enwi/RoomSensor/pcb/RoomSensor.kicad_pcb

## KiCad design pcb/RoomSensor.kicad_pcb (2023-08-02)

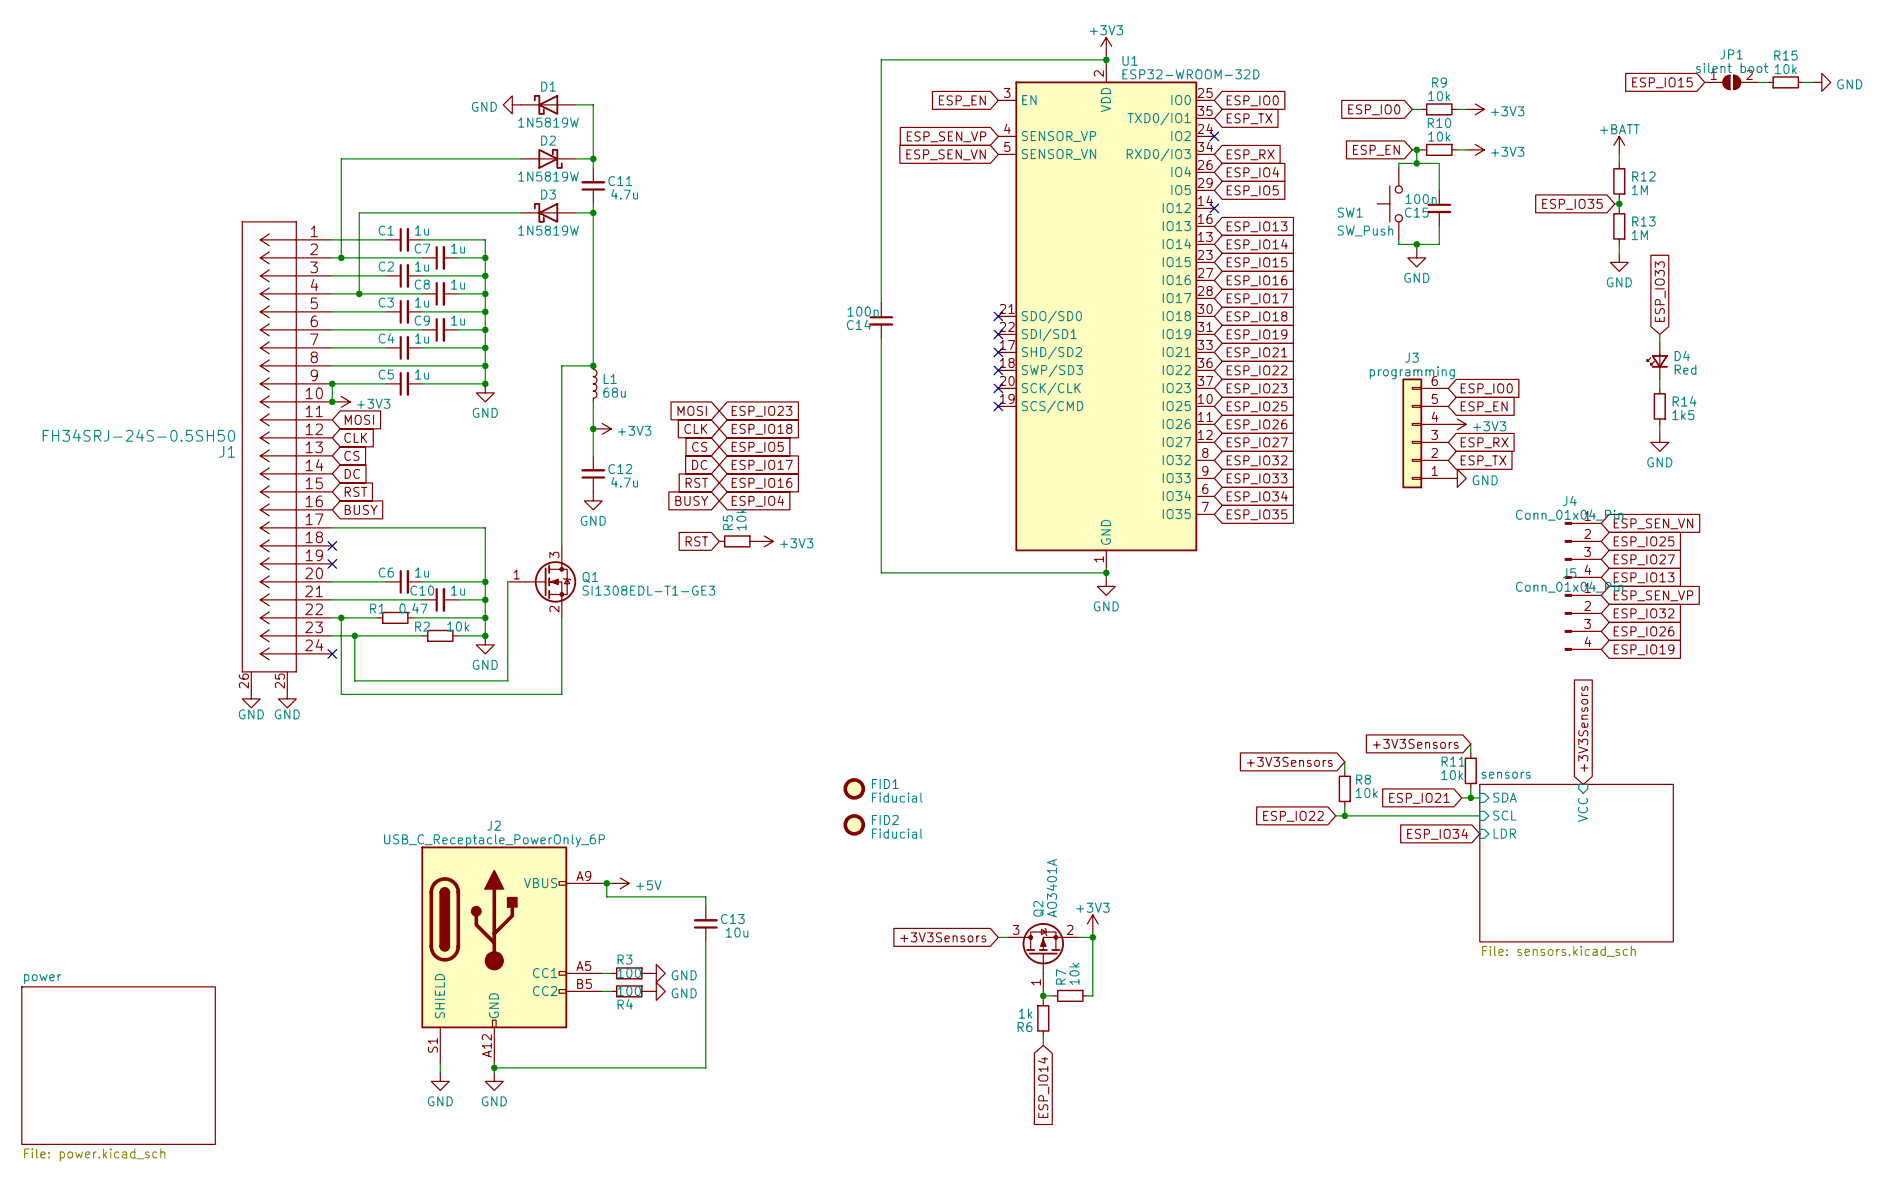
[picture p1: schematic RoomSensor.kicad_sch]

Parts:
C1, C2, C3, C4, C5, C6, C7, C8, C9, C10: 1u; C_0603_1608Metric
C11, C12: 4.7u; C_0603_1608Metric
C13: 10u; C_0603_1608Metric
C14, C15: 100n; C_0603_1608Metric
D1, D2, D3: 1N5819W; D_SOD-323
D4: Red; LED_0603_1608Metric
FID1, FID2: Fiducial; Fiducial_0.5mm_Mask1.5mm
J1: FH34SRJ-24S-0.5SH50
J2: USB_C_Receptacle_PowerOnly_6P; TYPE-C 6P LCH10.0
J3: programming; PinSocket_1x06_P2.54mm_Vertical
J4, J5: Conn_01x04_Pin; PinHeader_1x04_P2.54mm_Vertical
JP1: silent boot; SolderJumper-2_P1.3mm_Open_TrianglePad1.0x1.5mm
L1: 68u; L_0805_2012Metric_Pad1.15x1.40mm_HandSolder
Q1: SI1308EDL-T1-GE3; SOT-323_SC-70
Q2: AO3401A; SOT-23
R1: 0.47; R_0603_1608Metric
R2, R5, R7, R8, R9, R10, R11, R15: 10k; R_0603_1608Metric
R3, R4: 100; R_0603_1608Metric
R6: 1k; R_0603_1608Metric
R12, R13: 1M; R_0603_1608Metric
R14: 1k5; R_0603_1608Metric
SW1: SW_Push; TSB001A3826A
U1: ESP32-WROOM-32D

Connections:
+3V3: C5.1, C12.2, C14.1, J1.9, J1.10, J3.4, L1.2, Q2.2 (S), R5.1, R7.1, R9.2, R10.1, U1.2 (VDD); also elsewhere on the board
+3V3Sensors: Q2.3 (D), R8.2, R11.2; also elsewhere on the board
+5V: C13.2, J2.A9 (VBUS), J2.B9 (VBUS); also elsewhere on the board
+BATT: R12.2; also elsewhere on the board
BUSY: J1.16, U1.26 (IO4)
CLK: J1.12, U1.30 (IO18)
CS: J1.13, U1.29 (IO5)
DC: J1.14, U1.28 (IO17)
ESP_EN: C15.1, J3.5, R10.2, SW1.2, U1.3 (EN)
ESP_IO0: J3.6, R9.1, U1.25 (IO0)
ESP_IO13: J4.4, U1.16 (IO13)
ESP_IO14: R6.2, U1.13 (IO14)
ESP_IO15: JP1.1 (A), U1.23 (IO15)
ESP_IO16: J1.15, R5.2, U1.27 (IO16)
ESP_IO19: J5.4, U1.31 (IO19)
ESP_IO21: R11.1, U1.33 (IO21); also elsewhere on the board
ESP_IO22: R8.1, U1.36 (IO22); also elsewhere on the board
ESP_IO23: J1.11, U1.37 (IO23)
ESP_IO25: J4.2, U1.10 (IO25)
ESP_IO26: J5.3, U1.11 (IO26)
ESP_IO27: J4.3, U1.12 (IO27)
ESP_IO32: J5.2, U1.8 (IO32)
ESP_IO33: D4.2 (A), U1.9 (IO33)
ESP_IO34: U1.6 (IO34); also elsewhere on the board
ESP_IO35: R12.1, R13.2, U1.7 (IO35)
ESP_RX: J3.3, U1.34 (RXD0/IO3)
ESP_SEN_VN: J4.1, U1.5 (SENSOR_VN)
ESP_SEN_VP: J5.1, U1.4 (SENSOR_VP)
ESP_TX: J3.2, U1.35 (TXD0/IO1)
GND: C1.2, C2.2, C3.2, C4.2, C5.2, C6.2, C7.2, C8.2, C9.2, C10.2, C12.1, C13.1, C14.2, C15.2, D1.1 (K), J1.8, J1.17, J1.25, J1.26, J2.A12 (GND), J2.B12 (GND), J2.S1 (SHIELD), J3.1, R1.2, R2.2, R3.1, R4.1, R13.1, R14.1, R15.2, SW1.1, U1.1 (GND), U1.15 (GND), U1.38 (GND), U1.39 (GND); also elsewhere on the board
unnamed: C1.1, J1.1
unnamed: C2.1, J1.3
unnamed: C3.1, J1.5
unnamed: C4.1, J1.7
unnamed: C6.1, J1.20
unnamed: C9.1, J1.6
unnamed: C10.1, J1.21
unnamed: C11.2, D1.2 (A), D2.1 (K)
unnamed: C7.1, D2.2 (A), J1.2
unnamed: C11.1, D3.2 (A), L1.1, Q1.3 (D)
unnamed: C8.1, D3.1 (K), J1.4
unnamed: D4.1 (K), R14.2
unnamed: J2.A5 (CC1), R3.2
unnamed: J2.B5 (CC2), R4.2
unnamed: JP1.2 (B), R15.1
unnamed: J1.23, Q1.1 (G), R2.1
unnamed: J1.22, Q1.2 (S), R1.1
unnamed: Q2.1 (G), R6.1, R7.2

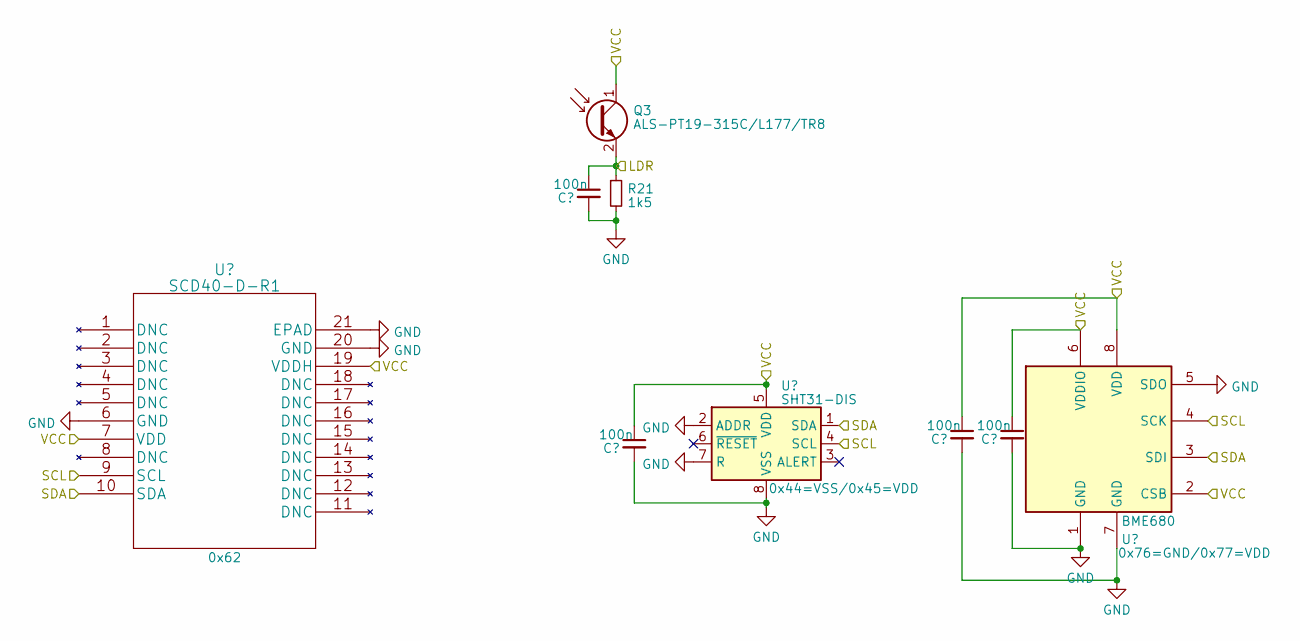
[picture p2: schematic sensors.kicad_sch]

Parts:
C21, C22, C23, C24: 100n; C_0603_1608Metric
Q3: ALS-PT19-315C/L177/TR8; LED_0603_1608Metric
R21: 1k5; R_0603_1608Metric
U6: SCD40-D-R1
U7: SHT31-DIS; Sensirion_DFN-8-1EP_2.5x2.5mm_P0.5mm_EP1.1x1.7mm
U8: BME680; Bosch_LGA-8_3x3mm_P0.8mm_ClockwisePinNumbering

Connections:
+3V3Sensors: C22.1, C23.1, C24.1, Q3.1 (C), U6.7 (VDD), U6.19 (VDDH), U7.5 (VDD), U8.2 (CSB), U8.6 (VDDIO), U8.8 (VDD); also elsewhere on the board
ESP_IO21: U6.10 (SDA), U7.1 (SDA), U8.3 (SDI); also elsewhere on the board
ESP_IO22: U6.9 (SCL), U7.4 (SCL), U8.4 (SCK); also elsewhere on the board
ESP_IO34: C21.1, Q3.2 (E), R21.1; also elsewhere on the board
GND: C21.2, C22.2, C23.2, C24.2, R21.2, U6.6 (GND), U6.20 (GND), U6.21 (EPAD), U7.2 (ADDR), U7.7 (R), U7.8 (VSS), U7.9 (VSS), U8.1 (GND), U8.5 (SDO), U8.7 (GND); also elsewhere on the board

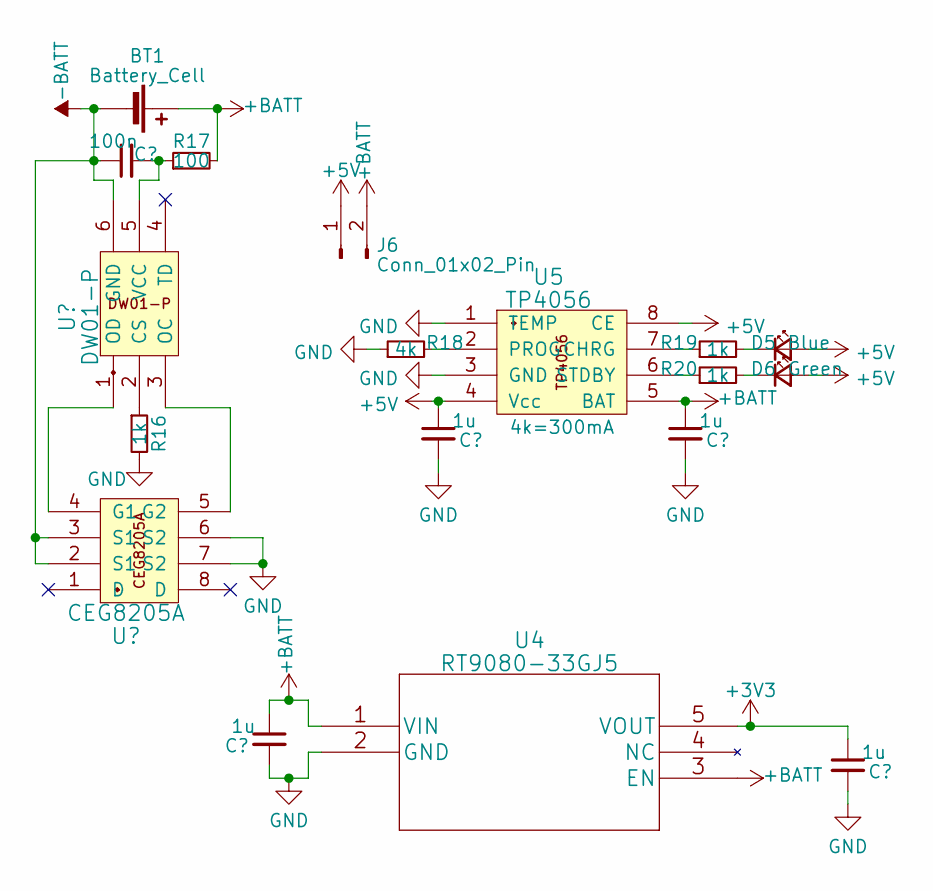
[picture p3: schematic power.kicad_sch]

Parts:
BT1: Battery_Cell; PinHeader_1x02_P2.54mm_Vertical
C16: 100n; C_0603_1608Metric
C17, C18, C19, C20: 1u; C_0603_1608Metric
D5: Blue; LED_0603_1608Metric
D6: Green; LED_0603_1608Metric
J6: Conn_01x02_Pin; PinHeader_1x02_P2.54mm_Vertical
R16, R19, R20: 1k; R_0603_1608Metric
R17: 100; R_0603_1608Metric
R18: 4k; R_0603_1608Metric
U2: DW01-P; SOT-23-6
U3: CEG8205A; TSSOP-8_4.4x3mm_P0.65mm
U4: RT9080-33GJ5
U5: TP4056; SOIC-8-1EP_3.9x4.9mm_P1.27mm_EP2.29x3mm_ThermalVias

Connections:
+3V3: C20.1, U4.5 (VOUT); also elsewhere on the board
+5V: C18.1, D5.2 (A), D6.2 (A), J6.1, U5.4 (Vcc), U5.8 (CE); also elsewhere on the board
+BATT: BT1.1 (+), C17.1, C19.1, J6.2, R17.2, U4.1 (VIN), U4.3 (EN), U5.5 (BAT); also elsewhere on the board
-BATT: BT1.2 (-), C16.1, U2.6 (GND), U3.2 (S1), U3.3 (S1)
GND: C17.2, C18.2, C19.2, C20.2, R16.2, R18.1, U3.6 (S2), U3.7 (S2), U4.2 (GND), U5.1 (TEMP), U5.3 (GND), U5.9 (HeatPad); also elsewhere on the board
unnamed: D5.1 (K), R19.2
unnamed: D6.1 (K), R20.2
unnamed: R16.1, U2.2 (CS)
unnamed: U2.3 (OC), U3.5 (G2)
unnamed: U2.1 (OD), U3.4 (G1)
unnamed: C16.2, R17.1, U2.5 (VCC)
unnamed: R19.1, U5.7 (CHRG)
unnamed: R18.2, U5.2 (PROG)
unnamed: R20.1, U5.6 (STDBY)

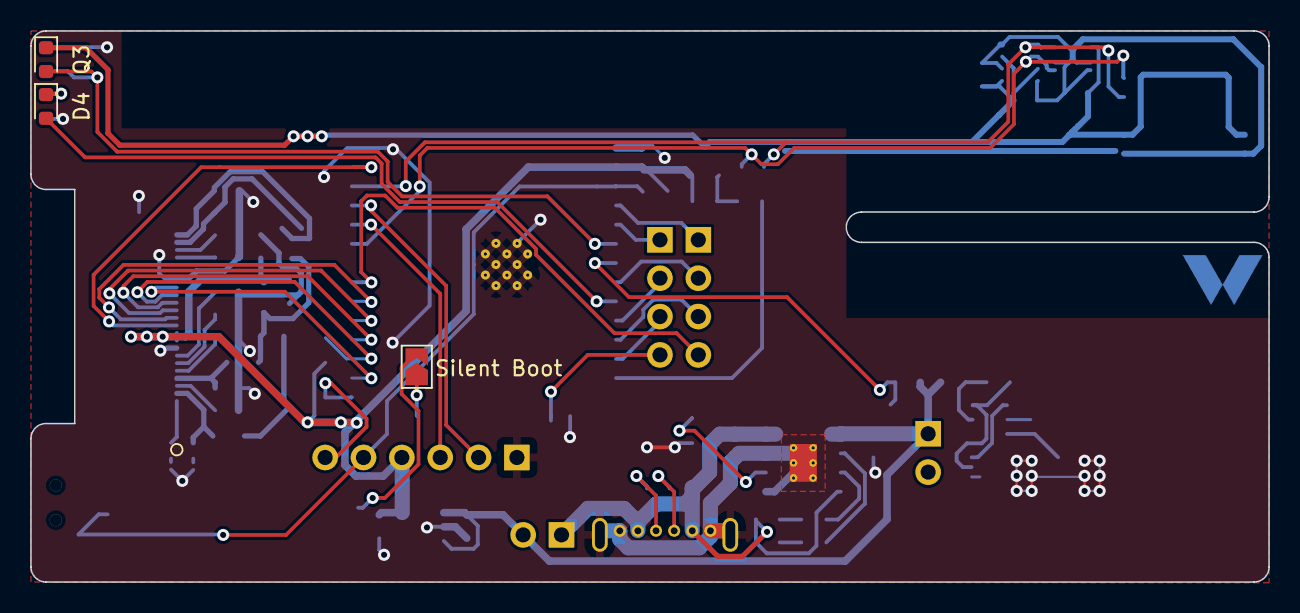
[picture p4: board RoomSensor.kicad_pcb from above]

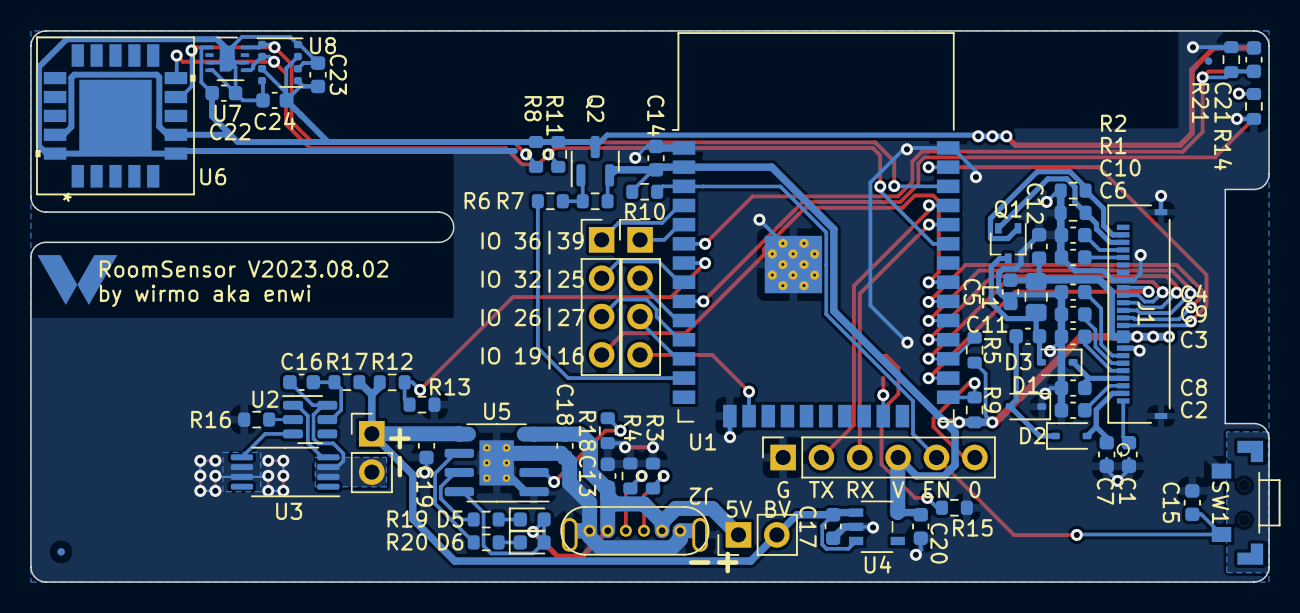
[picture p5: board RoomSensor.kicad_pcb from below]

Board: 2 copper layers, 82.0 x 36.5 mm, 74 parts (71 on the bottom side), 58 nets.
