enwi/RoomSensor/code/include/Icons.h

// 'humidity', 50x50px
unsigned char epd_bitmap_humidity[] PROGMEM = {0x00, 0x00, 0x00, 0x00, 0x00, 0x00, 0x00, 0x00, 0x00, 0x00, 0xe0, 0x00,
    0x00, 0x00, 0x00, 0x00, 0x00, 0xe0, 0x00, 0x00, 0x00, 0x00, 0x00, 0x01, 0xf0, 0x00, 0x00, 0x00, 0x00, 0x00, 0x01,
    0xf0, 0x00, 0x00, 0x00, 0x00, 0x00, 0x03, 0xf8, 0x00, 0x00, 0x00, 0x00, 0x00, 0x07, 0xfc, 0x00, 0x00, 0x00, 0x00,
    0x00, 0x07, 0x1c, 0x00, 0x00, 0x00, 0x00, 0x00, 0x0f, 0x1e, 0x00, 0x00, 0x00, 0x00, 0x00, 0x0e, 0x0e, 0x00, 0x00,
    0x00, 0x00, 0x00, 0x1c, 0x07, 0x00, 0x00, 0x00, 0x00, 0x00, 0x1c, 0x07, 0x00, 0x00, 0x00, 0x00, 0x00, 0x38, 0x03,
    0x80, 0x00, 0x00, 0x00, 0x00, 0x78, 0x03, 0xc0, 0x00, 0x00, 0x00, 0x00, 0x70, 0x01, 0xc0, 0x00, 0x00, 0x00, 0x00,
    0xf0, 0x01, 0xe0, 0x00, 0x00, 0x00, 0x00, 0xe0, 0x00, 0xe0, 0x00, 0x00, 0x00, 0x01, 0xc0, 0x00, 0x70, 0x00, 0x00,
    0x00, 0x03, 0xc0, 0x00, 0x78, 0x00, 0x00, 0x00, 0x03, 0x80, 0x00, 0x38, 0x00, 0x00, 0x00, 0x07, 0x80, 0x00, 0x3c,
    0x00, 0x00, 0x00, 0x07, 0x00, 0x00, 0x1c, 0x00, 0x00, 0x00, 0x0f, 0x00, 0x00, 0x1e, 0x00, 0x00, 0x00, 0x0e, 0x00,
    0x00, 0x0e, 0x00, 0x00, 0x00, 0x1c, 0x00, 0x00, 0x07, 0x00, 0x00, 0x00, 0x3c, 0x00, 0x04, 0x07, 0x80, 0x00, 0x00,
    0x38, 0x00, 0x0e, 0x03, 0x80, 0x00, 0x00, 0x38, 0x1c, 0x1e, 0x03, 0x80, 0x00, 0x00, 0x70, 0x1c, 0x3c, 0x01, 0xc0,
    0x00, 0x00, 0x70, 0x18, 0x38, 0x01, 0xc0, 0x00, 0x00, 0x70, 0x00, 0x78, 0x01, 0xc0, 0x00, 0x00, 0x70, 0x00, 0xf0,
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

// Array of all bitmaps for convenience. (Total bytes used to store images in PROGMEM = 1104)
const int epd_bitmap_allArray_LEN = 3;
unsigned char* epd_bitmap_allArray[3] = {epd_bitmap_humidity, epd_bitmap_temperature, epd_bitmap_window_open};
