enwi/RoomSensor/(commit log)

2023-02-19 Initial pcb commit
    [RoomSensor.kicad_pcb, RoomSensor.kicad_sch, power.kicad_sch, sensors.kicad_sch]
2023-02-25 Increase PCB size and fix EPD pinout
    [RoomSensor.kicad_pcb, RoomSensor.kicad_sch, sensors.kicad_sch]
2023-04-01 Ignore build and gerber files
2023-04-01 Fix low power issues
    - Fix spurious EPD wakeups by adding pull-up to EPD reset line
    - Reduce power consumption by switching sensors off with mosfet
    - Connect button to reset to reduce power by not needing rtc gpio
    - Add solder jumper for silent boot
    [RoomSensor.kicad_pcb, RoomSensor.kicad_sch, power.kicad_sch, sensors.kicad_sch]
2023-04-01 Ignore gerber, bom and report files
2023-07-30 Replace b- net with -Battery
    [RoomSensor.kicad_pcb, RoomSensor.kicad_sch, power.kicad_sch]
2023-08-02 Move epd connector and fix net
    [RoomSensor.kicad_pcb]
2023-08-05 Add missing HomeAssistant.h file
    [Base.h, Debug.h, HomeAssistant.h]
2023-08-06 Fix auto discovery and also publish battery voltage
    - Tweak battery voltage conversion
    [Key.h, Sensor.h, Sensors.h, Unit.h]
